TheFloatingLab/BoilerOptimizer/SchematicDiagram.png

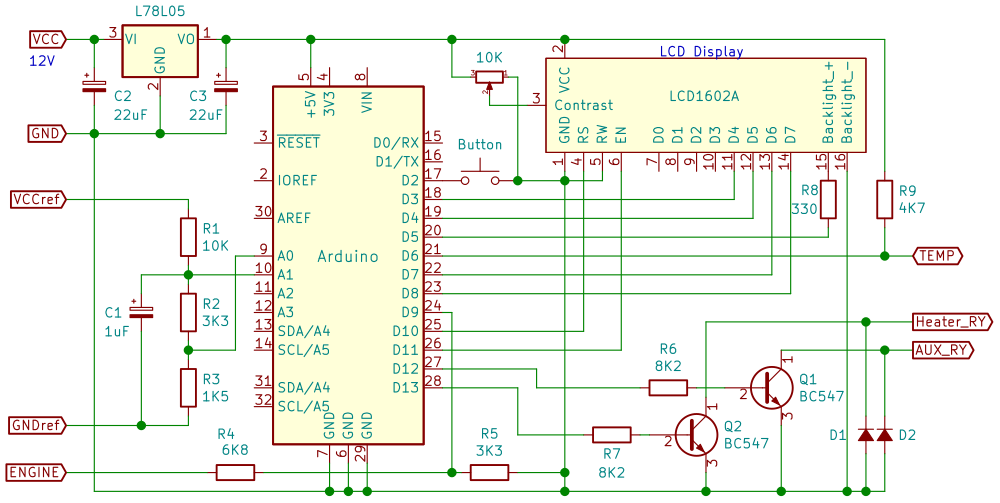
SchematicDiagram.png
