TheFloatingLab/BoilerOptimizer/(commit log)

2022-01-22 Initial upload of the schematic, readme and license. Source code will follow soon
2022-01-22 Added the source code and corrected the URL in the README.md
    [boileroptimizer.ino]
